rorygleeson/AirWatch/Devices/WiFi/2.jpg

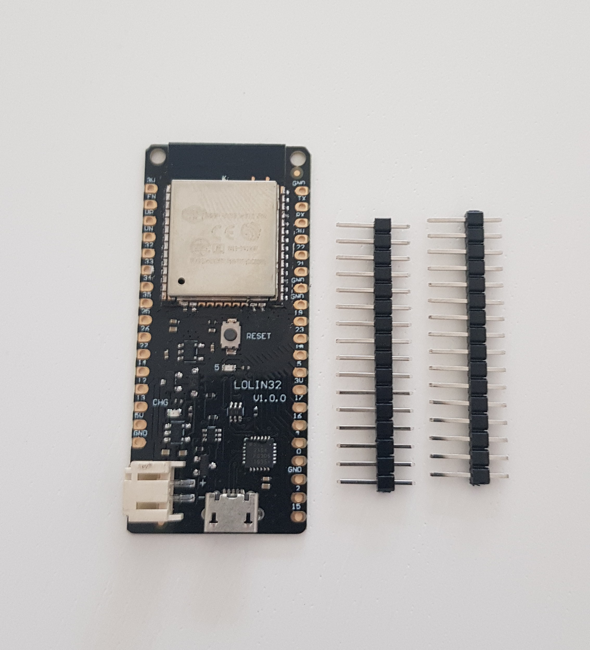
Devices/WiFi/2.jpg
