rorygleeson/AirWatch/Devices/WiFi/3.jpg

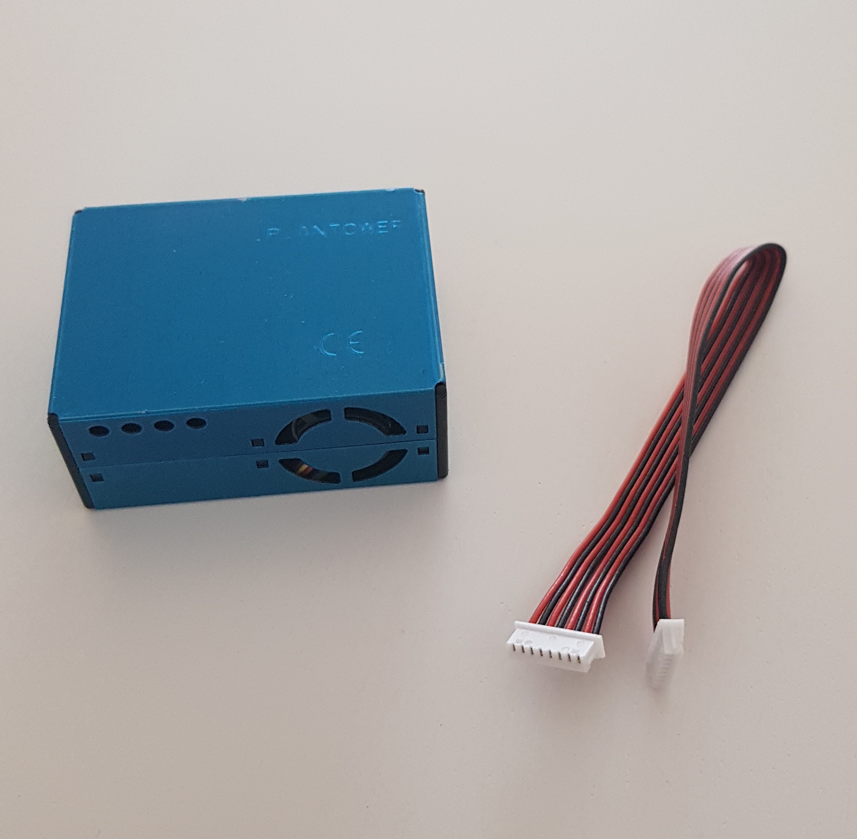
Devices/WiFi/3.jpg
