rorygleeson/AirWatch/Devices/WiFi/5.jpg

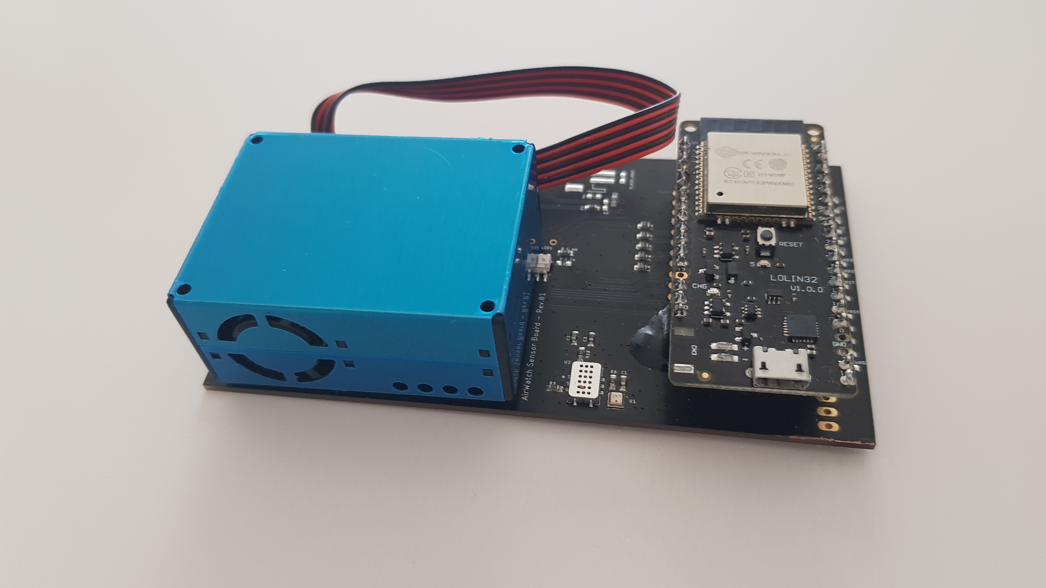
Devices/WiFi/5.jpg
