rorygleeson/AirWatch/Devices/WiFi/6.jpg

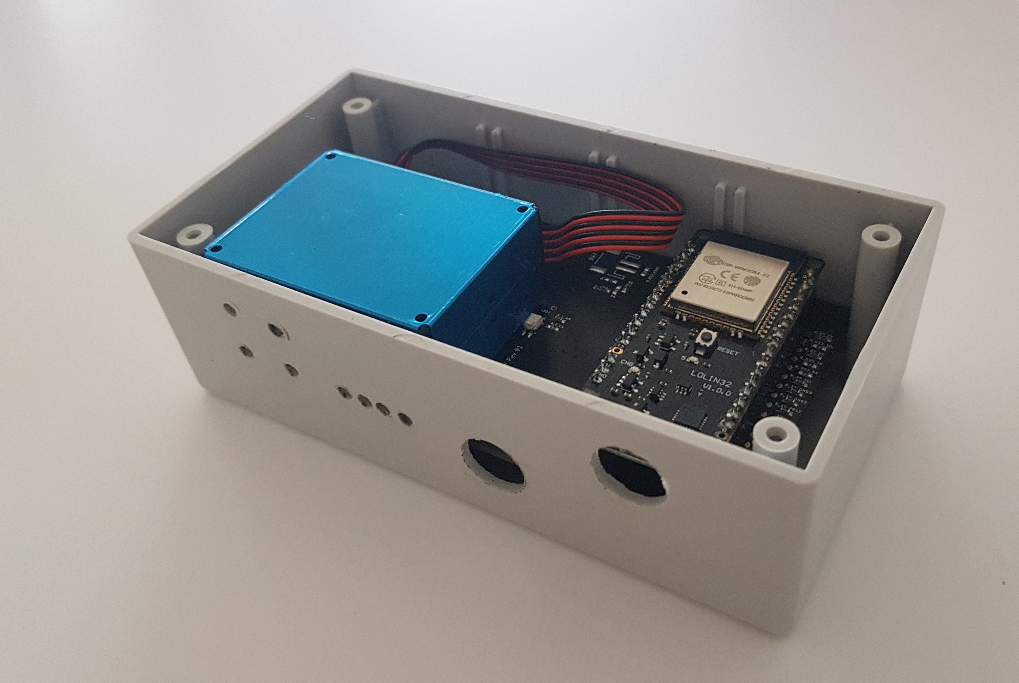
Devices/WiFi/6.jpg
