rorygleeson/AirWatch/Devices/WiFi/AirWatchLED.png

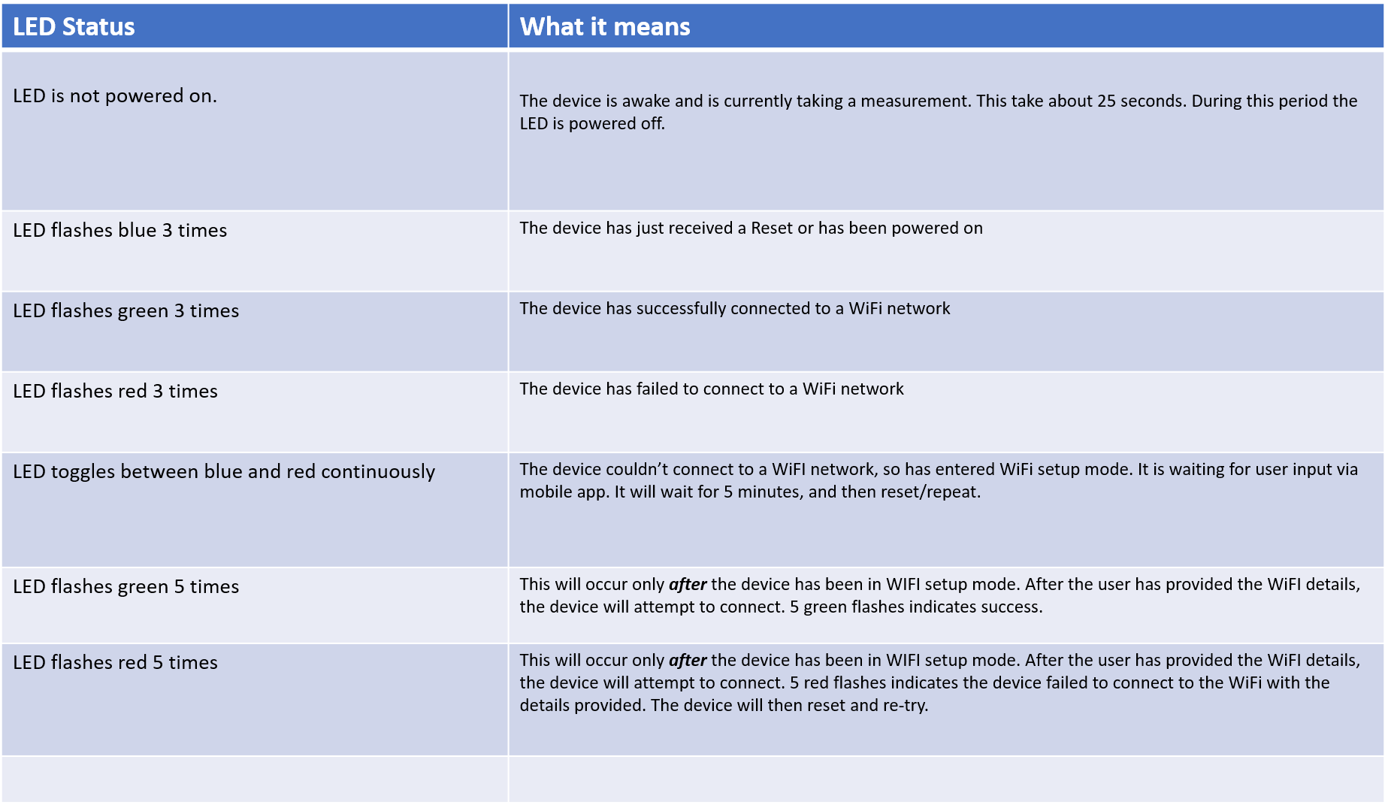
Devices/WiFi/AirWatchLED.png
