rorygleeson/AirWatch/Devices/WiFi/esptouchapp.PNG

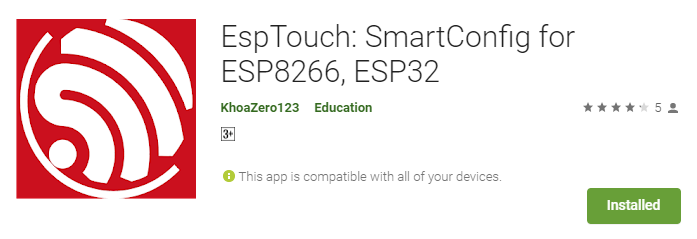
Devices/WiFi/esptouchapp.PNG
