rorygleeson/AirWatch/Devices/WiFi/AirWatchOperation.png

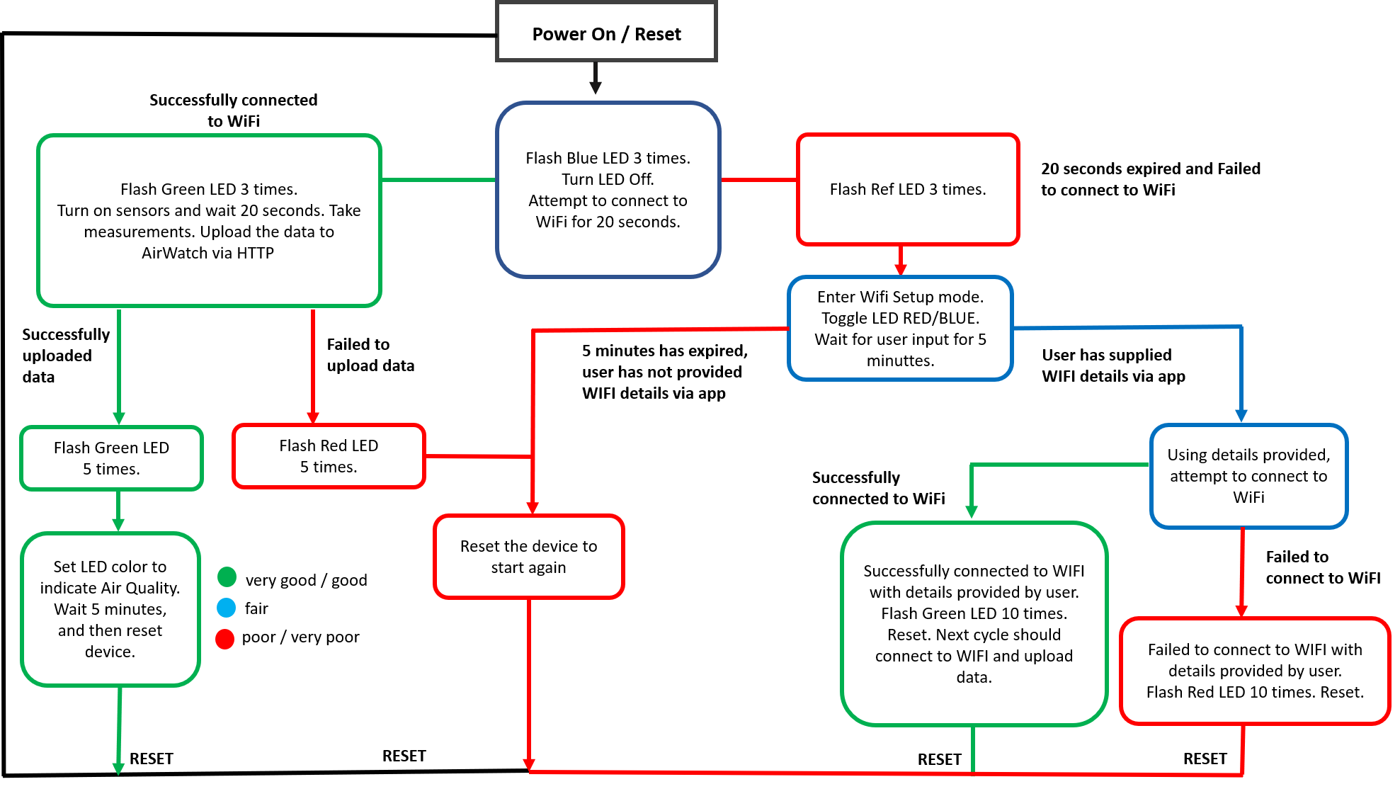
Devices/WiFi/AirWatchOperation.png
