rorygleeson/AirWatch/Devices/WiFi/AirWatchSetup.png

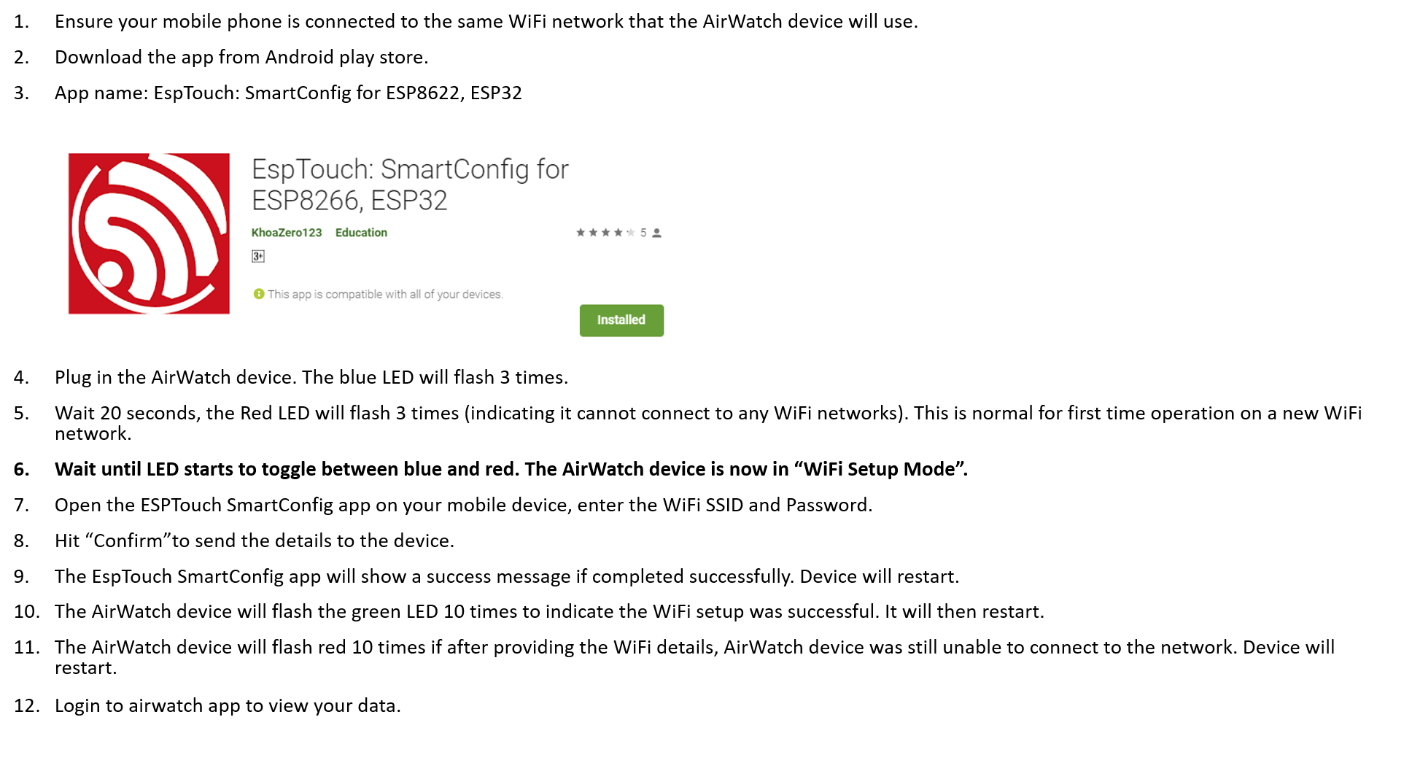
Devices/WiFi/AirWatchSetup.png
